GSobral99/arduino-can-bus-simulator/screenshots/physical_build_stage2.jpeg

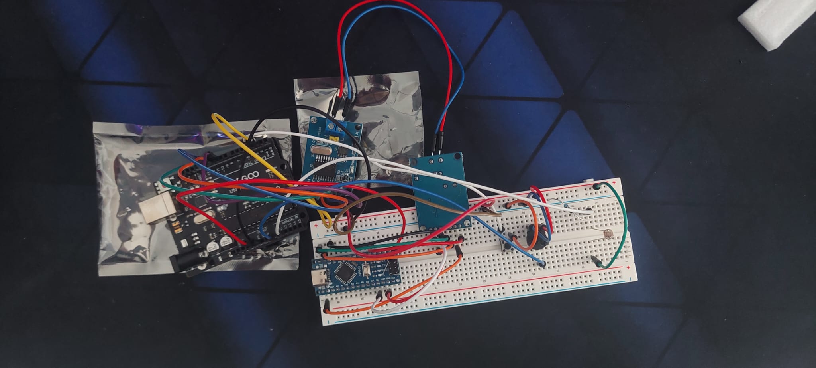
screenshots/physical_build_stage2.jpeg
