GSobral99/arduino-can-bus-simulator/(commit log)

2026-08-28 Stage 1: minimal two-node CAN network (simulated values)
2026-08-28 Stage 1: removed bus-off recovery for better testing in stage 2
2026-08-28 Stage 1: added physical photo
2026-08-30 Stage 2: real sensor input (potentiometer, LDR, button)
